tunsoethu62/furuta-pendulum/docs/FURUTA_MODEL_WORKED_CALCULATION.pdf

## Furuta pendulum with a stepper arm: model, linearisation and LQR design — worked calculation

2026-11-04

First hardware balance test passed (2026-11-04, one run)

Prepared for typesetting (LaTeX-ready). Every number below was recomputed independently (numpy, DARE solved by iteration) and matches analysis/lqr_design.py.

Evidence labels used throughout. [D] = derivation (pure mathematics). [I] = identified from our own measurements. [S] = simulation only. [H] = measured on hardware. [A] = assump-tion. First hardware balance test passed (2026-11-04, one run). Disturbance response, repeatability and swing-up not yet tested.

## 1 Coordinates, signs and units

Symbol | Meaning | Unit
θ | arm angle about the vertical motor axis; positive = clockwise
| seen from above (the f command) [H] | rad
α | pendulum angle about the hinge, measured from hanging
| down; positive = the AS5600 count direction | rad
d = α − π | pendulum angle from upright; d = 0 is the balance point | rad
Lr = 0.070 | motor axis to pendulum hinge (measured, approximate) | m
mp = 0.012 | pendulum mass (measured) | kg
lp | hinge to pendulum centre of mass (not yet measured) | m
Jp | pendulum inertia about the hinge | kg m²
bp | equivalent viscous hinge damping | N m s
g = 9.81 | gravity | m/s²
u = ¨θ | model input: arm angular acceleration | rad/s²

Stepper: 1/16 microstepping, 3200 steps per revolution, i.e. 3200/360 = 8.889 steps per degree [H, verified: 800 steps = 90◦
| ].

Note: the instructor handout orders the state as [α, α, θ, ˙

˙θ] and our code uses x = [θ, d, ˙θ, ḋ]. The ordering is a bookkeeping choice; the sign conventions above are what matter. [A: the handout’s own sign convention for θ and α was not compared line by line.]

## 2 Why the model input is acceleration, not torque

General (torque) model. Let the arm have inertia Jr and viscous friction br about the motor axis, driven by motor torque τ . The Euler–Lagrange equations for the two coordinates q = (θ, α)

are
d
dt

∂L
∂q˙i

−

∂L
∂qi

= Qi

, | Qθ = τ − br
˙θ, | Qα = −bpα. ˙

This gives one arm equation (it contains τ , Jr, br) and one pendulum equation (it does not contain τ ).

Reduction for a stepper. A stepper that does not miss steps imposes the arm motion θ(t) itself. Then θ is no longer an unknown: ¨θ = u is a prescribed function of time. The pendulum equation contains θ only through ˙θ, ¨θ, so it can be solved with u as input. The arm equation is no longer needed for the dynamics; it only tells us what torque the motor would have to deliver:

τrequired =

Jr + mpL

2

r + . . .
u + coupling terms + br

˙θ.

Therefore Jr, br and all motor constants drop out of the design. They only decide whether the motor can follow the commanded u without missing steps — a hardware limit that is not verified (see §10).

## 3 Pendulum equation (Lagrange) [D]

Take unit vectors er = (cos θ,sin θ, 0), eθ = (− sin θ, cos θ, 0), ez = (0, 0, 1) (z up). Let the pendulum swing in the plane spanned by eθ and ez, with the angle α measured from the downward vertical and positive along +eθ (derivation convention). The centre of mass is

r = Lrer + lp sin α eθ − lp cos α ez.

Using eṙ = ˙θeθ, e˙θ = − ˙θer:

r˙ = (Lr

˙θ + lp cos α α˙) eθ − lp sin α ˙θ er + lp sin α α e ˙ z,
|r˙|

2 = L

2
r

˙θ

2 + 2Lrlp cos α ˙θα˙ + l
2
pα˙

2 + l

2
p

sin² α ˙θ
2
Kinetic energy of the pendulum, for a slender pendulum (inertia about its own axis neglected) with
Jp = Ic + mpl

2
p

:

Tp =

1
2mpL

2
r

˙θ

2 + mpLrlp cos α ˙θα˙ +
1/2 Jpα˙

2 +

1/2 Jp sin² α ˙θ
2
, V = −mpglp cos α.

The α equation:
d
dt

∂T
∂α˙

= Jpα¨ + mpLrlp

cos α ¨θ − sin α ˙θα˙
,

∂T
∂α = −mpLrlp sin α ˙θα˙ + Jp sin α cos α ˙θ
2
,

∂V
∂α = mpglp sin α.

The ˙θα˙ terms cancel, leaving

Jpα¨ + bpα˙ + mpglp sin α + mpLrlp cos α ¨θ − Jp sin α cos α ˙θ 2 = 0.

Sign convention. With α positive along +eθ (the direction of arm motion) the coupling term has coefficient +mpLrlp cos α on the left, i.e. s = −1 in the form below. Physically correct: accelerating the hinge forward makes the bob lag backwards. If instead the encoder counts positive in the opposite direction, α → −α flips the sign and s = +1. We therefore write

Jpα¨ + bpα˙ + mpglp sin α = s mplpLr cos α ¨θ + Jp sin α cos α ˙θ
2
, s = ±1.

s depends on the direction in which the AS5600 counts increase relative to the arm’s forward direction. It is found from the 1 Hz sine test (§6), not assumed.

Centrifugal term. The term Jp sin α cos α ˙θ is dropped. Near upright, sin α cos α = sin d cos d ≈ d, so the term is ≈ Jpd

˙θ

2 — a product of the small variable d and ˙θ
2
. Compared with the gravity restoring term it modifies the stiffness by ∆(ω

2
n

) ∼ ˙θ
2
, so it is negligible when

˙θ
2 ≪ ω

2
n ≈ 146 (rad/s)

2

At ˙θ = 1 rad/s the ratio is ˙θ
2/ω

2
n = 0.7%. At the sketch’s speed limit (2π rad/s) it is 27%, so the linear model is not valid at that speed. Balancing should stay at small speeds. [A, D]

## 4 Normalised form [D]

Divide by Jp and define

ω

2
n =

mpglp
Jp

, 2ζωn =

bp
Jp

, leq =

Jp
mplp

=

g
ω²
n

, K =

Lr

leq

Then, with u = ¨θ and the centrifugal term neglected,

α¨ + 2ζωnα˙ + ω

2
n

sin α = s K cos α u.

Only ωn, ζ and K appear. mp and lp drop out of the design (they are needed only for the handout’s parameter sheet).

**Bound on lp.** Since Jp = Ic + mpl

2
p ≥ mpl

2
p

, we have leq = Jp/(mplp) ≥ lp, so lp ≤ leq. With the identified leq = 6.7 cm and a 7 cm pendulum, the mass must be concentrated near the tip (leq = 7 cm would be a point mass at the tip). A uniform rod of length 7 cm would give leq =
2/3· 7 = 4.7
cm, so it is not a uniform rod.

## 5 Identified numbers [I]

5.1 Natural frequency. The free-decay period (arm held, motor off) is T = 0.516 s (run 1) and 0.523 s (run 2); we use T = 0.52 s. The damping is light, so ωd ≈ ωn:

ωn =

2π
T

=

2π
0.52

= 12.083 rad/s, ω²
n = 146.0 (rad/s)

2

5.2 Equivalent length.

leq =

g
ω²
n

=

9.81
146.0

= 0.06719 m = 6.72 cm.

5.3 Input gain.

K =

Lr

leq

=

0.070
0.06719

= 1.0418.

### 5.4 Damping ratio. The logarithmic decrement between successive same-side peaks is δ =

ln(xn/xn+1). Run 1 peaks −86.1

- → −59.5
- and +54.7
- → +36.5

◦
:

δ = ln 86.1
59.5

= 0.370, δ = ln 54.7
36.5

= 0.405.

Using ζ = δ/

√
4π

2 + δ

2:

ζ(0.370) = 0.059, | ζ(0.405) = 0.064, | ζ(0.46) = 0.073.

Later cycles give δ = 0.58, 0.69 (ζ = 0.09, 0.11): the decrement is not constant, which a viscous model would require. We use the first-cycle value

ζ ≈ 0.06 (equivalent viscous; range 0.05–0.07 on the first cycle).

### 5.5 Dry (Coulomb) friction. The amplitude falls by an almost constant ∆ ≈ 11.4

- per half
cycle. For a pendulum with restoring torque ≈ mpglpα (small-angle approximation) and constant friction torque Tc, the equilibrium shifts to ±Tc/(mpglp) and the amplitude drops by 2Tc/(mpglp) each half cycle:
Tc
mpglp

=

∆
2

=

11.4

◦
- π/180
2

=

0.199
2

= 0.0995 ≈ 0.10.

With mp = 0.012: Tc = 0.10 · 0.012 · 9.81 · lp = 1.18 × 10−2 lp N m (lp in m). The formula is a small-angle approximation applied to swings up to 86◦
, so it is only indicative.

**5.6 Inertia and damping (need lp).**

Jp = mplpleq = 0.012 · 0.06719 · lp = 8.06 × 10−4 lp kg m²
, bp = 2ζωnJp.

These stay symbolic until lp is measured (balance the pendulum on an edge). They are not needed for the LQR design.

## 6 Sign s and model check against the open-loop sine tests [I]

For the hanging pendulum (α ≈ 0, sin α ≈ α, cos α ≈ 1) driven by θ = Θe

jωt
,

¨θ = −ω
2
θ:
ω

2
n − ω

2 + j 2ζωnω

α = −s Kω²
θ =⇒

α
θ
(jω) = | −s Kω²
ω²

n − ω² + j 2ζωnω

Magnitude:

α
θ
=

Kω²
p
(ω²

n − ω²)

2 + (2ζωnω)

2

Meaning of the sign. Well below resonance (ω ≪ ωn) the denominator is real and positive, so α/θ = −s · (positive): for s = +1 the pendulum is 180◦ out of phase with the arm; for s = −1 it is in phase.

1 Hz test (ω = 6.283 rad/s): Kω² = 1.0418 · 39.48 = 41.1; denominator 146.0 − 39.5 = 106.5 real, imaginary part 2 · 0.06 · 12.08 · 6.283 = 9.1, modulus 106.9:

α
θ
=

41.1
106.9

= 0.385, phase = 180◦ − arctan

9.1
106.5

= 175◦
(s = +1).

Measured [H]: ratio 0.31, phase ≈ 156◦
. The phase says the pendulum moves opposite to the arm, so **s = +1** [I]. The 19◦ phase difference is not explained by the model (encoder nonlinearity, arm angle is the commanded value, dry friction).

2 Hz test (ω = 12.566 rad/s): Kω² = 1.0418·157.9 = 164.5; denominator real part 146.0−157.9 = −11.9, imaginary part 2 · 0.06 · 12.083 · 12.566 = 18.2, modulus 21.8:

α
θ
=

164.5
21.8

= 7.56, phase = 180◦ −

180◦ − arctan 18.2
11.9
= 57◦

Measured [H]: ratio 4.9, phase 81◦ at a 40◦ amplitude.

Correction to an earlier statement. The predicted phase at 2 Hz is 57◦

, not ≈ 90◦

; 90◦ occurs
only exactly at ω = ωn. The measurement (81◦
) is closer to resonance than the model places it, which suggests the effective ωn at that amplitude is closer to 12.6 rad/s than 12.08. Near resonance both the ratio and the phase are very sensitive to ωn and ζ: for example ωn = 12.5 rad/s (with K recomputed) gives a ratio of 9.3 and a phase of 85◦

, and ωn = 12.3 gives 8.7 and 70◦ .

**Uncertainty of ωn [I].** Zero-crossing full periods from the two logs are 0.531, 0.523, 0.517, 0.538
s (run 1) and 0.556, 0.539, 0.528, 0.526, 0.515 s (run 2), i.e. ωn = 11.3–12.2 rad/s, with the period longer at large amplitude. With 10 ms sampling and the ±5

◦
encoder nonlinearity the uncertainty is about ±3%. Because leq ∝ 1/ω

2
n

, that gives ±6% in leq and in K. **Re-measure ωn at small amplitude (≤ 20◦
), three times**, before trusting K to better than 10 %. The simulation was run with K ± 20% (§9).

Conclusion. The model captures the right order of magnitude and the sign. The comparison is not a validation; the over-prediction is consistent with dry friction, the 40◦ nonlinear amplitude and the encoder error. [I]

## 7 Linearisation about upright [D]

Set α = π + d. Then sin α = − sin d ≈ −d, cos α = − cos d ≈ −1, and α˙ = ḋ. Substituting into the normalised equation:

¨d + 2ζωn

ḋ − ω
2

nd = −s K u =⇒ ¨d = ω
2
nd − 2ζωn

ḋ − s K u.

With x = [θ, d, ˙θ, ḋ]
⊤,

¨θ = u:

x˙ = Ax + Bu, A =

0 | 0 | 1 | 0
0 | 0 | 0 | 1
0 | 0 | 0 | 0
0 ω
| 2
n | 0 −2ζωn

, B =

0
0
1
−sK

Numerically (s = +1, ω

2
n = 146.0, 2ζωn = 1.450, K = 1.0418):

A =

0 | 0 | 1 | 0
0 | 0 | 0 | 1
0 | 0 | 0 | 0
0 146.0 0 −1.450

, B =

0
0
1
−1.0418

The first two rows are kinematics (˙θ = ˙θ,

ḋ = ḋ). Row 3 says the arm acceleration is the input. Row 4 is the pendulum.

## 8 Stability and controllability [D, I]

Characteristic equation. The first two rows couple to rows 3–4 only through the lower-right structure; expanding det(sI − A):

det(sI − A) = s

2

s

2 + 2ζωns − ω

2
n
= 0.

Roots: s = 0 (double, the arm integrator chain) and

s = −ζωn ± ωn

p
1 + ζ

2.

Numerically ζωn = 0.725, ωn

p
1 + ζ

2 = 12.083 · 1.0018 = 12.105:

s1 = −0.725 + 12.105 = +11.38, s2 = −0.725 − 12.105 = −12.83 rad/s.

One positive real root: the upright is unstable, with a time constant 1/11.38 = 88 ms. That is why the loop must run much faster than this (200 Hz = 5 ms is ≈ 18 samples per time constant).

Controllability matrix. C = [B AB A²B A³B] with

AB =

1
−K
0
2ζωnK

, A²B =

0
2ζωnK
0
−Kω²
n

(1 + 4ζ

2
)

, A³B =

0
−Kω²
n

(1 + 4ζ

2
)
0
2ζω³
nK(2 + 4ζ

2
)

Numerically (columns B, AB, A²B, A³B; rows θ, d, ˙θ, ḋ):

C =

0 | 1 | 0 | 0
0 | −1.042 | 1.511 | −154.29
1 | 0 | 0 | 0
−1.042 | 1.511 | −154.29 | 444.26

Expand the determinant along row 1 (its only nonzero entry is the 1 in column 2, cofactor sign −1), then along the row of the remaining minor that contains a single 1 (cofactor sign −1). The two sign flips cancel, leaving det C = ∆ with ∆ the 2 × 2 determinant of rows d, ḋ and columns A²B, A³B:

∆ =

2ζωnK | −Kω² n
(1 + 4ζ

2
)
−Kω²
n

(1 + 4ζ

2

| ) 2ζω³ nK(2 + 4ζ

2
)
= K²ω

4
n

h
4ζ

2
(2 + 4ζ

2
) − (1 + 4ζ

2
)

2

i

The bracket simplifies to 8ζ

2 + 16ζ

4 − 1 − 8ζ

2 − 16ζ

4 = −1, so ∆ = −K²ω

4
n and

det C = −K²ω

| 4

n = −(1.0418)²

(146.0)² = −2.31 × 10⁴
̸= 0.

The rank is 4 for every ζ, as long as K ̸= 0 and ωn ̸= 0. The system is controllable [D]; the numerical rank computed by the script is also 4.

## 9 Discrete LQR design [D, S]

Cost. Minimise J =

X∞

k=0

x

⊤
k Qxk + u

⊤
k Ruk
subject to xk+1 = Adxk + Bduk.

**Discretisation (zero-order hold, ∆t = 5 ms).**
Ad | Bd
0 | 1

= expA B

0 0
∆t

**Weights (Bryson’s rule: 1/(acceptable value)

2
).**
Q = diag
1
0.5

2 ,

1
0.08² ,

1
3

2 ,

1
5

2

= diag(4, 156.25, 0.1111, 0.04), R =

1

15² = 4.444 × 10−3
,

that is 0.5 rad of arm drift, 0.08 rad (4.6

◦
) pendulum error, 3 rad/s arm speed, 5 rad/s pendulum speed, 15 rad/s² acceleration. These are design choices [A]: tighter weights balanced in simulation but chattered because of encoder quantisation and derivative noise.

Method (Riccati). Solve the discrete algebraic Riccati equation

P = A

⊤
d P Ad − A

⊤
d P Bd (R + B

⊤
d P Bd)

−1B

⊤
d P Ad + Q,

and form the gain
Kd = (R + B

⊤
d P Bd)

−1B

⊤
d P Ad, uk = −Kdxk.
It was solved by fixed-point iteration (and by scipy.linalg.solve_discrete_are in the script). Both give

Kd =

−27.555, −600.497, −14.217, −44.909 , u = −

k1θ + k2d + k3

˙θ + k4

ḋ

The closed-loop discrete eigenvalues have moduli 0.9308 (pair) and 0.9833 (pair), all < 1; as contin-uous poles ln λ/∆t: −14.3 ± 6.9j and −3.4 ± 2.4j rad/s. The fast pair is faster than the open-loop unstable pole (11.4 rad/s), as it must be.

Sanity check 1 — signs. k2 < 0 means u = −k2d = +600 d: for d > 0 the arm accelerates in +θ. From ¨d = ω
2

nd − sKu with s = +1 this makes ¨d more negative and pushes d back to zero — the right correction direction. If s were −1 the same gains would destabilise the loop, which is why s must be right.

Sanity check 2 — pendulum alone. Keep only k2, k4 (ignore the arm states). Then

¨d = (ω
2
n + Kk2) d + (−2ζωn + Kk4)

ḋ = −479.6 d − 48.24 ḋ,

with roots −14.0 and −34.2 rad/s. Stability requires ω

2

n + Kk2 < 0, i.e. |k2| > ω² n/K =
146.0/1.0418 = 140.1; our 600.5 is 4.3 times that limit. The −14.0 rad/s root matches the fast closed-loop pole above.

Sanity check 3 — static (steady-state) condition. In steady state u = 0,

¨θ = 0,

˙θ = 0,

ḋ = 0.
Row 4 then forces d = 0. If the pendulum angle used by the controller has a calibration bias b
(dmeas = d + b), u = 0 requires k1θ + k2b = 0:

θss = −

k2
k1

b = −

−600.497
−27.555

b = −21.8 b.

A 1

- bias therefore makes the arm sit ≈ 22◦ off centre, matching the simulation (−21.7

◦
). The
sketch’s slow auto-trim c˙ = −kiθ (ki = 0.023) integrates this offset away; it is an addition to the LQR, outside the LQR optimality proof [S].

Simulation results [S, not hardware]. A nonlinear simulation (5° start, quantised encoder, filtered derivative, 1-sample delay, |u| ≤ 100 rad/s²
) balances for the nominal plant and with
K × 0.8 and K × 1.2; with a 1
- bias the trim removes the 22◦ arm offset. It does not include dry hinge friction, the ±5

◦
encoder nonlinearity or motor torque limits.

## 10 Implementation notes and what they assume

- Speed command. The controller integrates u to a speed command, ˙θ ← ˙θ + u ∆t, and uses the commanded speed as ˙θ in the feedback. This assumes the stepper really follows the commanded speed.
- Derivative. ḋ comes from a difference of the encoder angle through a 25 Hz low-pass (τ = 1/(2π · 25) = 6.4 ms). The filter delay is not in the LQR design.
- Untested motor limits. The arm test (§ motion_core) only reached 60◦/s (533 steps/s). The sketch allows 2π rad/s = 3200 steps/s and |u| ≤ 100 rad/s² = 5.1 × 10⁴

steps/s²
. A
stepper at 12 V loses torque at high step rates, so missed steps at these limits are likely and undetectable (no arm encoder).

## 11 Assumptions and limitations (summary)

1. No arm encoder. θ, ˙θ are the commanded values. Missed steps cannot be detected; the 90° test only verifies small slow moves. [H]
2. Dry hinge friction. About 10% of the maximum gravity torque; the pendulum stops abruptly and rests off-centre. The viscous model with ζ ≈ 0.06 is only an equivalent. Dry friction adds a dead band near upright.

3. Encoder nonlinearity about ±5

◦
(weak magnet). It limits the accuracy of ωn, ζ and the zero, and it is the same order as the controller’s workspace (±4

◦
catch window).
4. Identified parameters are uncertain: ωn ± 3%, hence K ± 6%; Lr is approximate; lp, Jp, bp are not measured.
5. Sign conventions. s = +1 was read from the 1 Hz phase (156◦ vs predicted 175◦
). The user
has not yet chosen the final direction convention for θ; if the encoder direction or the arm direction is changed, s must be re-derived.
6. Linear model validity. Needs small d and ˙θ
2 ≪ ω

2
n

(§3). No swing-up is covered here.

7. Delay and filtering are not in the LQR design (only in the simulation).
8. Hardware balancing: tested in one run; disturbance response, repeatability and swing-up not yet tested. The motor’s ability to deliver u across its full limits and the gains’ robustness to friction remain unverified beyond this run.

### 11.1 Robustness to hinge dry friction (simulation)

A crude simulation with stiction plus Coulomb friction of Tc = 0.10mpglp (the value estimated from the decay tests) predicts that the designed gains do not settle. The pendulum sticks about 0.9

- off
upright and the arm runs away to the ±90◦
software limit.

Tighter LQR gains (K = [−68.2, −1660.9, −40.1, −94.7]) give a limit cycle of about ±9

- on the
pendulum and about ±105◦ on the arm.

With Tc = 0.05mpglp the result is still a limit cycle of about ±5

- on the pendulum and about ±50◦ on the arm. Without friction it settles to within ±0.07◦

The simulation is indicative only (crude friction model): see analysis/friction_check.py and analysis/friction_check_output.txt.

Recommended next step: reduce the hinge friction mechanically, and check it with a driver-off ”does it stand tilted?” test.

On hardware the controller balanced despite the estimated friction, so this crude friction simulation was too pessimistic; the slow ±10–25◦ arm wander may partly come from friction and encoder error.

## 12 First hardware balance test

The first hardware balance test on 2026-11-04 balanced for 10.0 s and was still balancing when the log ended. [H]

Quantity | Measured result
Pendulum | max 3.6

◦

| from upright; rms 0.87◦ after 2 s
Arm | wandered between −9.9 ◦ and +24.9

◦
Control u | rms 18.5 rad/s
| 2 ; at the limit 0.3% of the time
Auto-trim | converged to −1.10◦
Run limits 100 rad/s
| 2 and 360◦/s (earlier limits)
Source: | docs/BALANCE_TEST_2026-11-04.md;
measured log data/balance_2026-11-04_1427.csv.

## 13 Next steps (evidence required)

1. Re-measure ωn at ≤ 20◦
, three runs; recompute leq, K.
2. Measure lp (edge balance) to complete Jp, bp, Tc.
3. Choose and record the θ direction convention; recheck s.
4. Hardware test of the balance controller with bounded limits (small Vmax, Umax) and the emergency stop; log θ, d, u, trim at 100 Hz; compare with the simulation.
