tunsoethu62/furuta-pendulum/docs/SWINGUP_TEST_2026-11-04_1532.md

# Swing-up v2 hardware run, 2026-11-04 15:32

Source: `data/device-monitor-261104-153252.log` (original byte-for-byte copy). Startup confirms v2, pump 100 rad/s^2 / 4.363323 rad/s, balance 60 / pi. No BALANCE state was recorded.

| Observation | Measured/logged result |
|---|---:|
| PUMP samples, 50 Hz | 1000 |
| First-to-last PUMP sample span | 19.979 s |
| Closest upright error | 16.37 degrees |
| Maximum excursion from down | 163.63 degrees |
| Commanded arm range | -18.56 to +52.43 degrees |
| Predictive arm-braking samples | 0 |
| Stop | 20-second swing-up timeout |

Closest sample (t=19959 ms): theta=9.79 degrees, d=16.37 degrees, filtered pendulum rate=-0.66 rad/s, arm command=-0.342 rad/s. It fails the 15-degree angle gate; its unsaturated A request is also about 142 rad/s^2, above the 75 capture gate. Merely widening the angle window would not make this sample catchable under the current gates. The 50 Hz log cannot establish every intervening 200 Hz state, but no transition was recorded.

## Confirmed software defect and correction (v2.1)

The absolute-peak tracker was initialized with the preceding tip's magnitude and kept taking an absolute maximum. On an asymmetric +150 -> -120 degree half-swing, it reported 150 degrees again: energy 1.866 rather than the current tip's 1.500. This was reproduced by a failing regression against the actual detector. The log has asymmetric tips (for example -163.63 followed by about +136.96 degrees), consistent with that defect affecting pumping. Its exact contribution to the hardware shortfall is not separately measurable from this log.

V2.1 tracks a **signed directional extreme**. Positive travel tracks max(alpha); negative travel tracks min(alpha). Each tip now uses its own angle. This prevents a larger previous swing from masking a smaller one and reducing its next planned push.

A second issue appeared during verification: full rotations bypassed the turning-point loss update and retained excessive compensation, creating repeated simulated overshoots. A detected full rotation now halves the learned compensation before the next pump. The overshoot backoff is a bounded tuning heuristic; it does not prove hardware convergence.

No changes to A, capture gates, acceleration/speed caps, travel limits, countdown, timeout or stop behavior. New boot banner: `swingup-v2.1`.

## Verification

- Regression reproduced the asymmetric-peak defect before correction; now passes in both directions.
- Full-rotation compensation-backoff regression passes.
- Direct parity with the untouched `balance/balance.ino` passes for 800 ticks.
- Core and full-sketch fault/cancellation/automatic-catch checks pass with assertions enabled.
- All ten required nonlinear scenarios capture and hold five seconds. Identified dry-friction case: 4.290 seconds to capture; coupling +/-15%: 4.490 / 3.945 seconds. The lossless case is still marginal at 19.385 seconds. Strict stiction stress still fails to hold and stops at commanded travel (capture 5.370 seconds).
- Uno builds pass: swingup 13,824 bytes flash / 529 bytes static RAM; balance 9,432 / 469.

Commands: `uv run --no-project --with ziglang python analysis/run_swingup_checks.py`; `pio run -e swingup -e balance`.

**Hardware v2.1 remains untested.** User uploads `swingup`, centers/calibrates with VMOT off, enables VMOT and uses `z`, `s`; `x` stops. Return a full log including the v2.1 banner. Simulations omit motor torque/missed steps and assume reduced friction near upright, as documented in `SWINGUP.md`. No firmware was uploaded and no commit was made by the agent.
